ikechangexentrick/quantizer_turingmachine/hw/Quantizer.kicad_pcb

## KiCad design hw/Quantizer.kicad_pcb (2022-06-20)

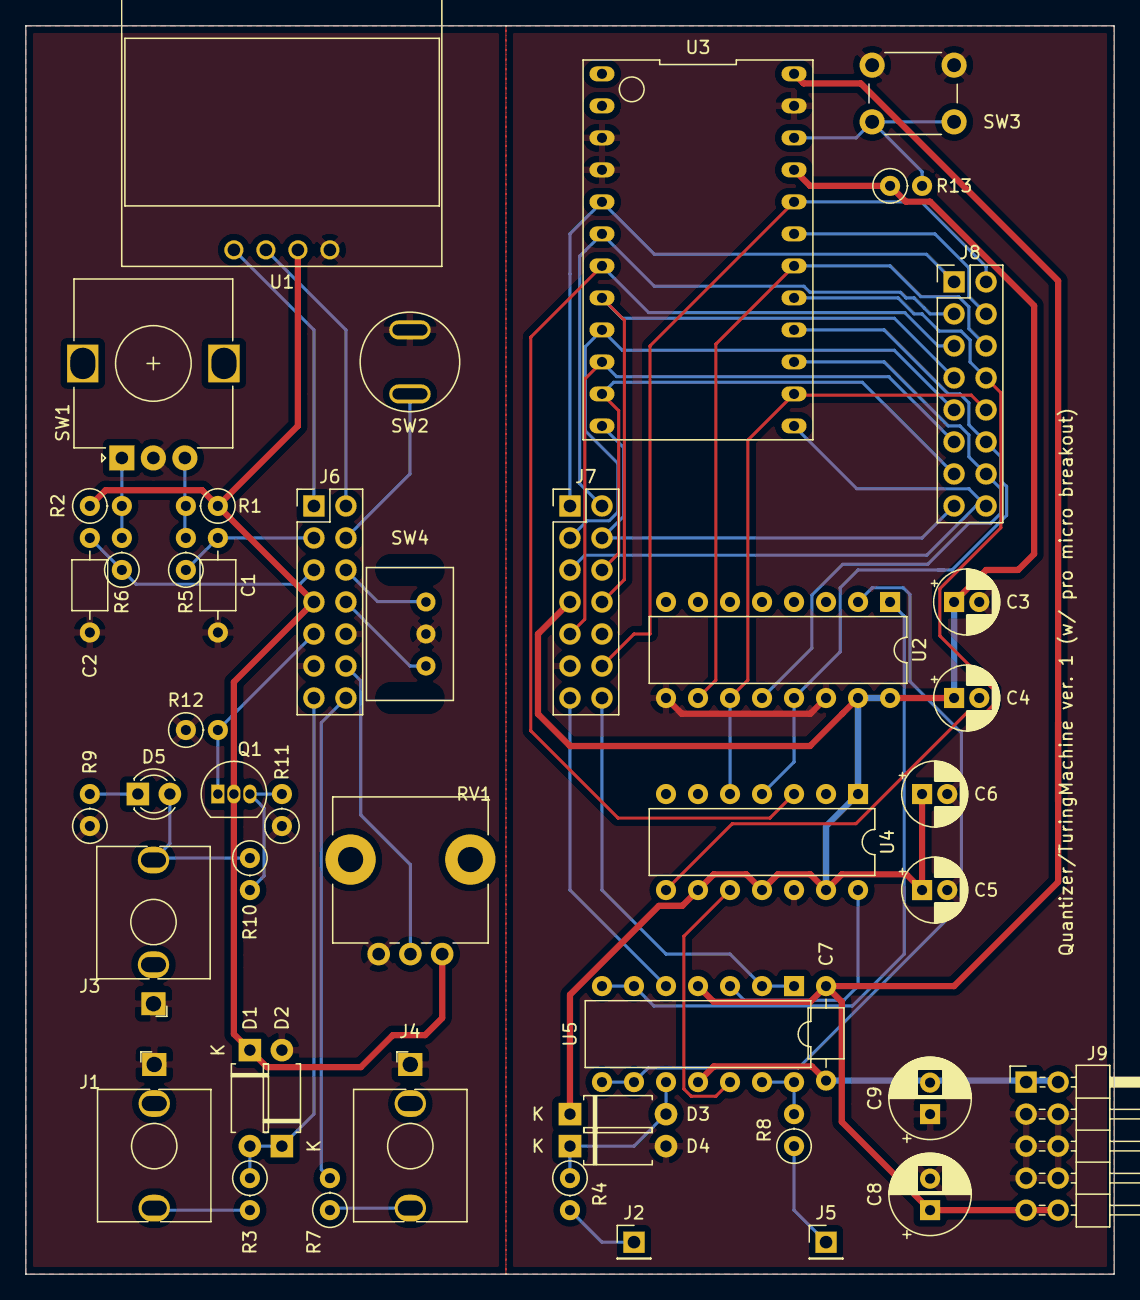
[picture p1: board Quantizer.kicad_pcb from above]

Board: 2 copper layers, 86.4 x 99.1 mm, 47 parts (0 on the bottom side), 49 nets.

Parts:
C1, C2, C7: 0.1u; C_Axial_L3.8mm_D2.6mm_P7.50mm_Horizontal
C3, C5: 10u; CP_Radial_D5.0mm_P2.00mm
C4, C6: 1u; CP_Radial_D5.0mm_P2.00mm
C8, C9: 100u; CP_Radial_D6.3mm_P2.50mm
D1, D2, D3, D4: D; D_A-405_P7.62mm_Horizontal
D5: LED; LED_D3.0mm
J1: Audio_in; mono_jack_3.5mm
J2: Audio_in_2; PinHeader_1x01_P2.54mm_Vertical
J3: gate_in; mono_jack_3.5mm
J4: Audio_out; mono_jack_3.5mm
J5: Audio_out_2; PinHeader_1x01_P2.54mm_Vertical
J6, J7: Conn_02x07_Odd_Even; PinHeader_2x07_P2.54mm_Vertical
J8: breakout; PinHeader_2x08_P2.54mm_Vertical
J9: power_bus; PinHeader_2x05_P2.54mm_Horizontal
Q1: 2SC1815; TO-92_Inline
R1, R2, R5, R6, R9, R13: 10k; R_Axial_DIN0207_L6.3mm_D2.5mm_P2.54mm_Vertical
R3, R4, R10, R11, R12: 100k; R_Axial_DIN0207_L6.3mm_D2.5mm_P2.54mm_Vertical
R7, R8: 1k; R_Axial_DIN0207_L6.3mm_D2.5mm_P2.54mm_Vertical
RV1: param; Potentiometer_Alps_RK09L_Single_Vertical
SW1: command; RotaryEncoder_Alps_EC12E_Vertical_H20mm
SW2: btn_enter; push_button
SW3: reset; SW_PUSH_6mm
SW4: write; SW_DPDT_Momentary
U1: OLED_Display_SSD1306; aki_OLED_0.96in
U2: MCP3208; DIP-16_W7.62mm
U3: ProMicro; Pro_Micro_Top_side_Up
U4: MCP4922; DIP-14_W7.62mm
U5: TL074; DIP-14_W7.62mm

Connections:
+5V: C3.1, C4.1, C5.1, C6.1, D1.1, D3.1, J6.7, J7.7, Q1.2, R1.1, R2.1, R13.1, RV1.3, U1.2, U2.15, U2.16, U3.21, U4.1, U4.9, U4.11, U4.13
+12V: C7.1, C8.1, J9.9, J9.10, U3.24, U5.4
-12V: C7.2, C9.2, J9.1, J9.2, U5.11
/Sheet628BAE91/TM_off: J6.6, SW4.1
/Sheet628BAE91/TM_on: J6.8, SW4.3
/Sheet628BAE91/TM_pot: J6.12, RV1.2
/Sheet628BAE91/audio_in_1: D1.2, D2.1, J6.13, R3.1
/Sheet628BAE91/audio_out_1: J6.14, R7.2
/Sheet628BAE91/btn_enter: J6.4, SW2.2
/Sheet628BAE91/gate: J6.9, Q1.1, R12.2
/Sheet628BAE91/i2c_clk: J6.2, U1.3
/Sheet628BAE91/i2c_data: J6.1, U1.4
/Sheet628BAE91/re_1: C2.1, J6.5, R6.1
/Sheet628BAE91/re_2: C1.1, J6.3, R5.1
/Sheet628BB73E/CS_AD: J8.6, U2.10, U3.18
/Sheet628BB73E/CS_DA: J8.5, U3.7, U4.3
/Sheet628BB73E/D14: J8.14, U2.12, U3.15
/Sheet628BB73E/D15: J8.12, U2.13, U3.16, U4.4
/Sheet628BB73E/D16: J8.10, U2.11, U3.14, U4.5
/Sheet628BB73E/D18_A0: J8.8, U3.17, U4.8
/Sheet628BB73E/D20_A2: J8.4, U3.19
/Sheet628BB73E/TM_off: J7.6, J8.13, U3.11
/Sheet628BB73E/TM_on: J7.8, J8.7, U3.8
/Sheet628BB73E/TM_pot: J7.12, J8.2, U3.20
/Sheet628BB73E/audio_in_1: J7.13, U5.5
/Sheet628BB73E/audio_out_1: J7.14, U5.1, U5.2
/Sheet628BB73E/btn_enter: J7.4, J8.15, U3.12
/Sheet628BB73E/gate: J7.9, J8.11, U3.10
/Sheet628BB73E/i2c_clk: J7.2, J8.3, U3.6
/Sheet628BB73E/i2c_data: J7.1, J8.1, U3.5
/Sheet628BB73E/re_1: J7.5, J8.16, U3.13
/Sheet628BB73E/re_2: J7.3, J8.9, U3.9
GND: C1.2, C2.2, C3.2, C4.2, C5.2, C6.2, C8.2, C9.1, D2.2, D4.2, J1.S, J3.S, J4.S, J6.10, J6.11, J7.10, J7.11, J9.3, J9.4, J9.5, J9.6, J9.7, J9.8, R9.1, R11.1, R12.1, RV1.1, SW1.C, SW2.1, SW3.2, SW4.2, U1.1, U2.9, U2.14, U3.3, U3.4, U3.23, U4.12
unnamed: D3.2, D4.1, R4.1, U5.10
unnamed: D5.1, R9.2
unnamed: D5.2, J3.T, R10.1
unnamed: J1.T, R3.2
unnamed: J2.1, R4.2
unnamed: J4.T, R7.1
unnamed: J5.1, R8.1
unnamed: Q1.3, R10.2, R11.2
unnamed: R1.2, R5.2, SW1.B
unnamed: R2.2, R6.2, SW1.A
unnamed: R8.2, U5.13, U5.14
unnamed: R13.2, SW3.1, U3.22
unnamed: U2.1, U5.6, U5.7
unnamed: U2.2, U5.8, U5.9
unnamed: U4.10, U5.12
unnamed: U4.14, U5.3
