ikechangexentrick/quantizer_turingmachine/(commit log)

2022-06-20 Added an user interface. Input via a rotary encoder and a button, and output via the serial terminal.
2022-06-20 Introduced Display class, to collect procedures for showing menu.
    Adjusted pin assigns.
2022-06-20 Software: followed library's update. Hardware: appended kicad project files.
    [ModuleCore.kicad_pcb, ModuleCore.sch, ModuleInterface.kicad_pcb, ModuleInterface.sch, Panel.kicad_pcb, Panel_TM.kicad_pcb, Panel_template.kicad_pcb, Quantizer.csv]
